asokolsky/AnalogNavigationKeyPad/doc/kit.jpg

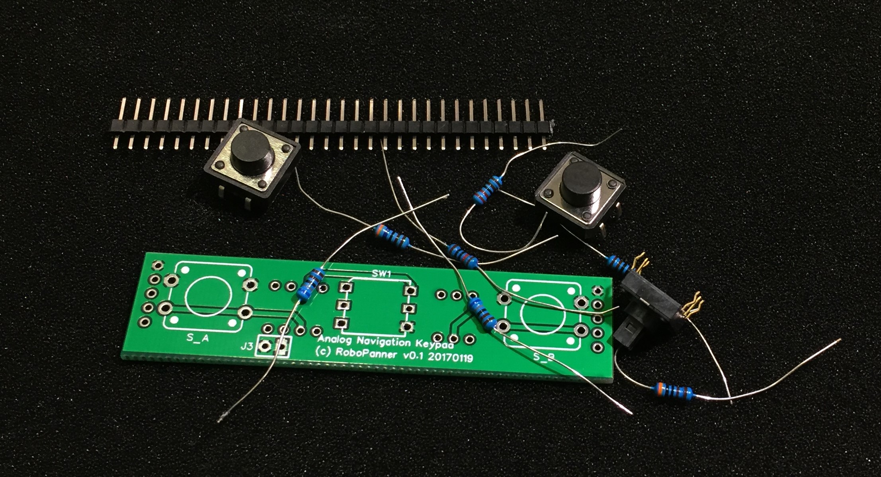
doc/kit.jpg
