asokolsky/AnalogNavigationKeyPad/doc/board.bot.jpg

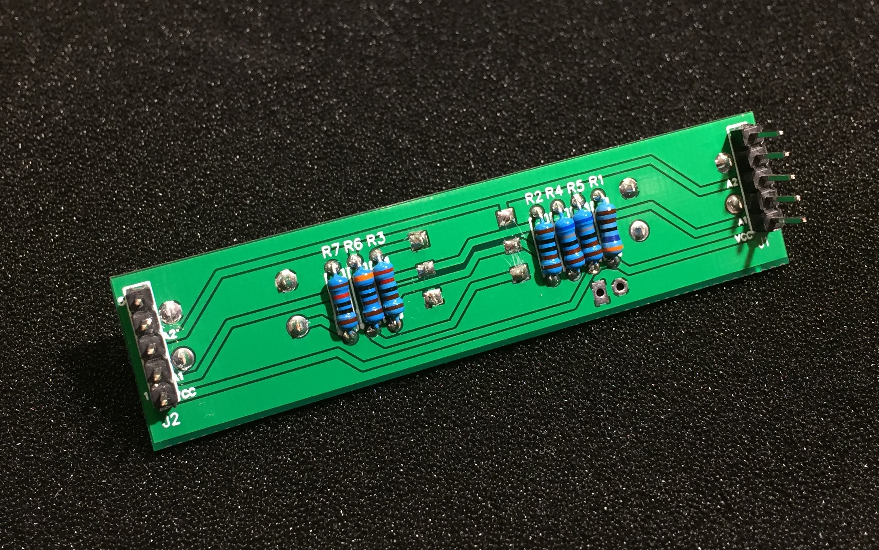
doc/board.bot.jpg
