asokolsky/AnalogNavigationKeyPad/log.md

1/24/2017
GITHUB repository started 

1/19/2017
Schematics and PCB ready.
