asokolsky/AnalogNavigationKeyPad/doc/board.top.jpg

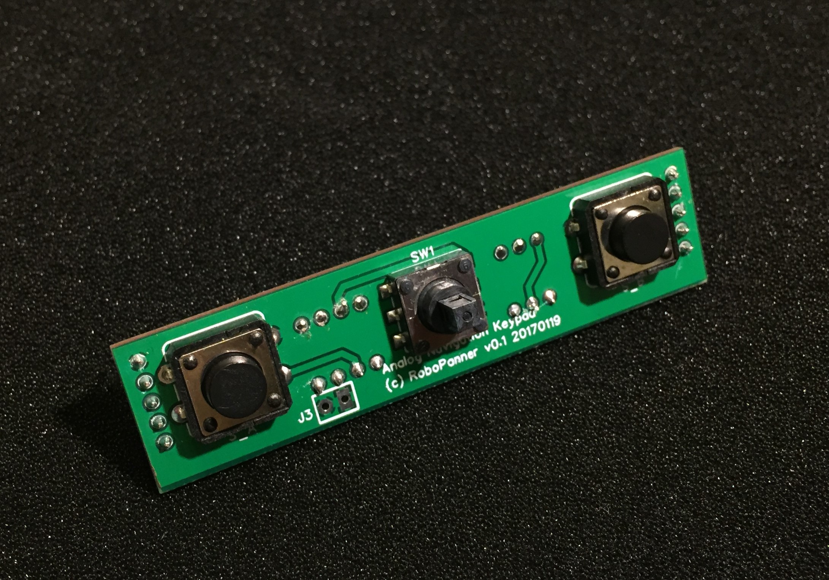
doc/board.top.jpg
