asokolsky/AnalogNavigationKeyPad/doc/PCB.0.1.bot.png

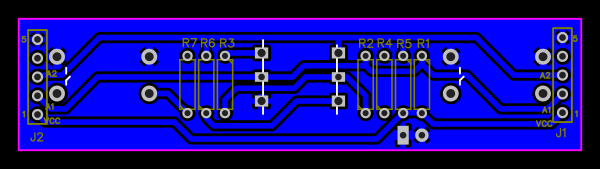
doc/PCB.0.1.bot.png
