asokolsky/AnalogNavigationKeyPad/doc/PCB.0.1.top.png

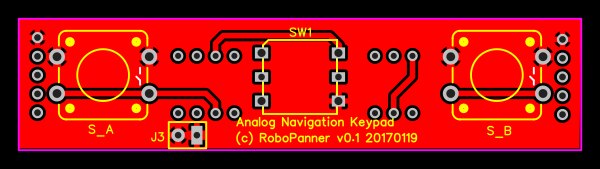
doc/PCB.0.1.top.png
