asokolsky/AnalogNavigationKeyPad/doc/PCB.0.2.bot.png

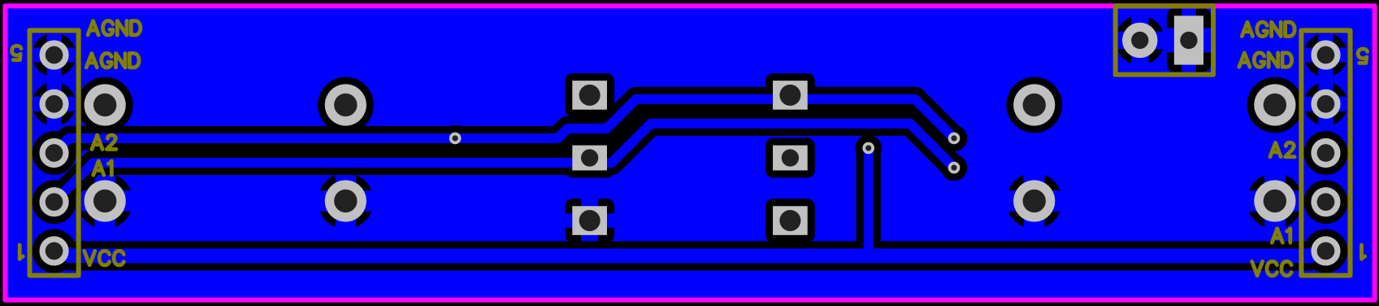
doc/PCB.0.2.bot.png
