asokolsky/AnalogNavigationKeyPad/doc/PCB.0.2.top.png

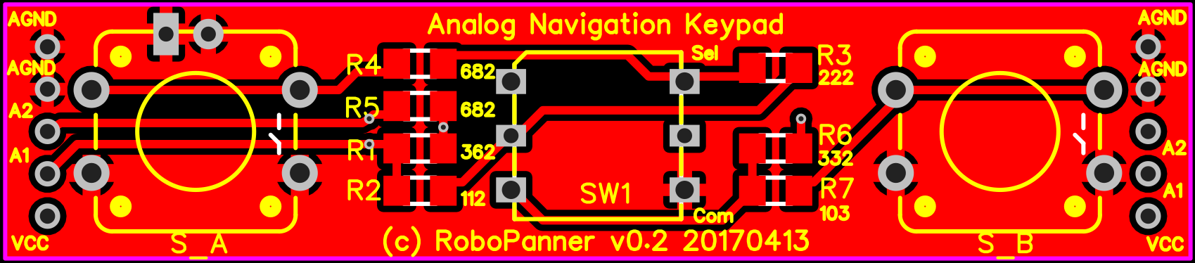
doc/PCB.0.2.top.png
