asokolsky/AnalogNavigationKeyPad/doc/PCB.0.3.bot.png

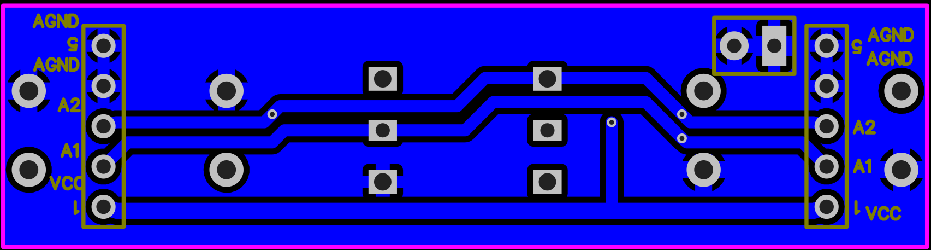
doc/PCB.0.3.bot.png
