asokolsky/AnalogNavigationKeyPad/doc/PCB.0.3.top.png

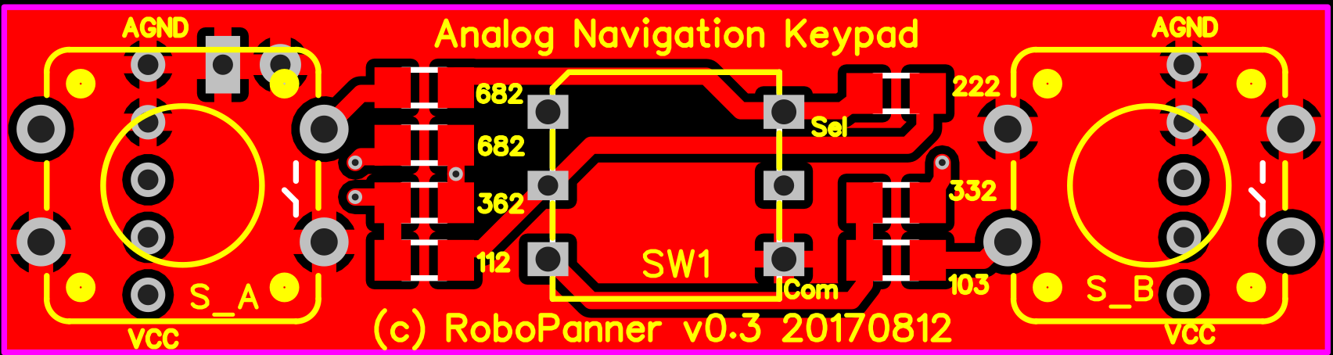
doc/PCB.0.3.top.png
