asokolsky/AnalogNavigationKeyPad/doc/PCB.0.4.bot.png

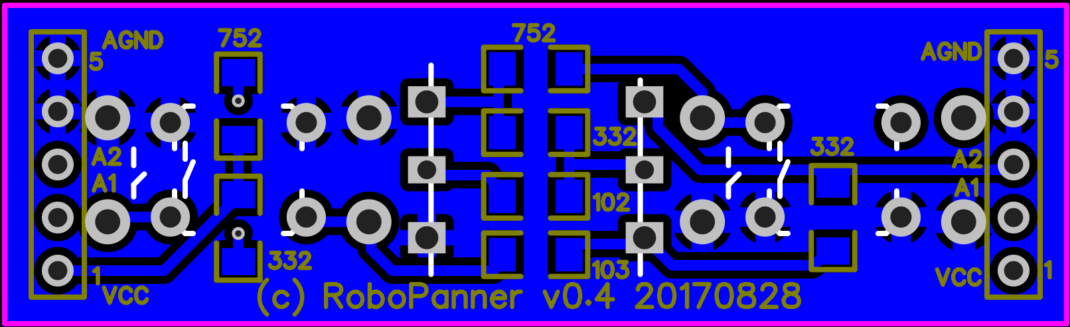
doc/PCB.0.4.bot.png
