asokolsky/AnalogNavigationKeyPad/doc/PCB.0.4.top.png

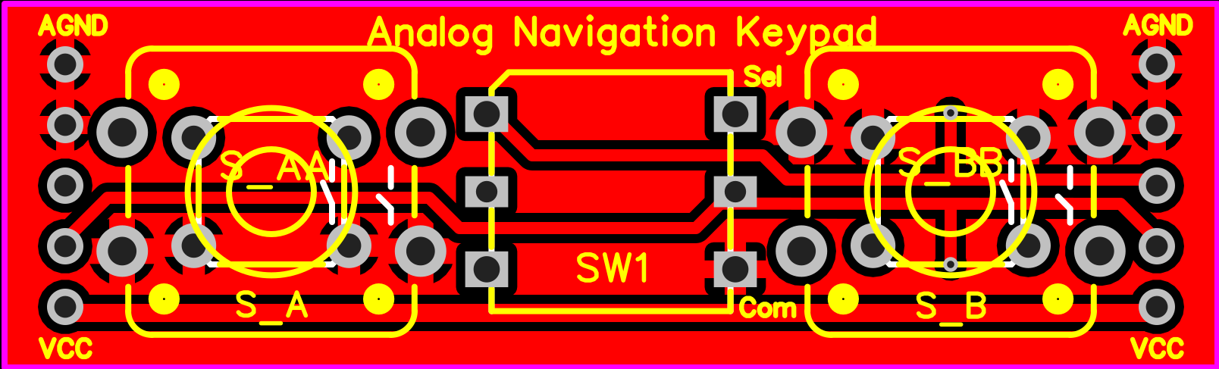
doc/PCB.0.4.top.png
