asokolsky/AnalogNavigationKeyPad/doc/Schematic.0.1.png

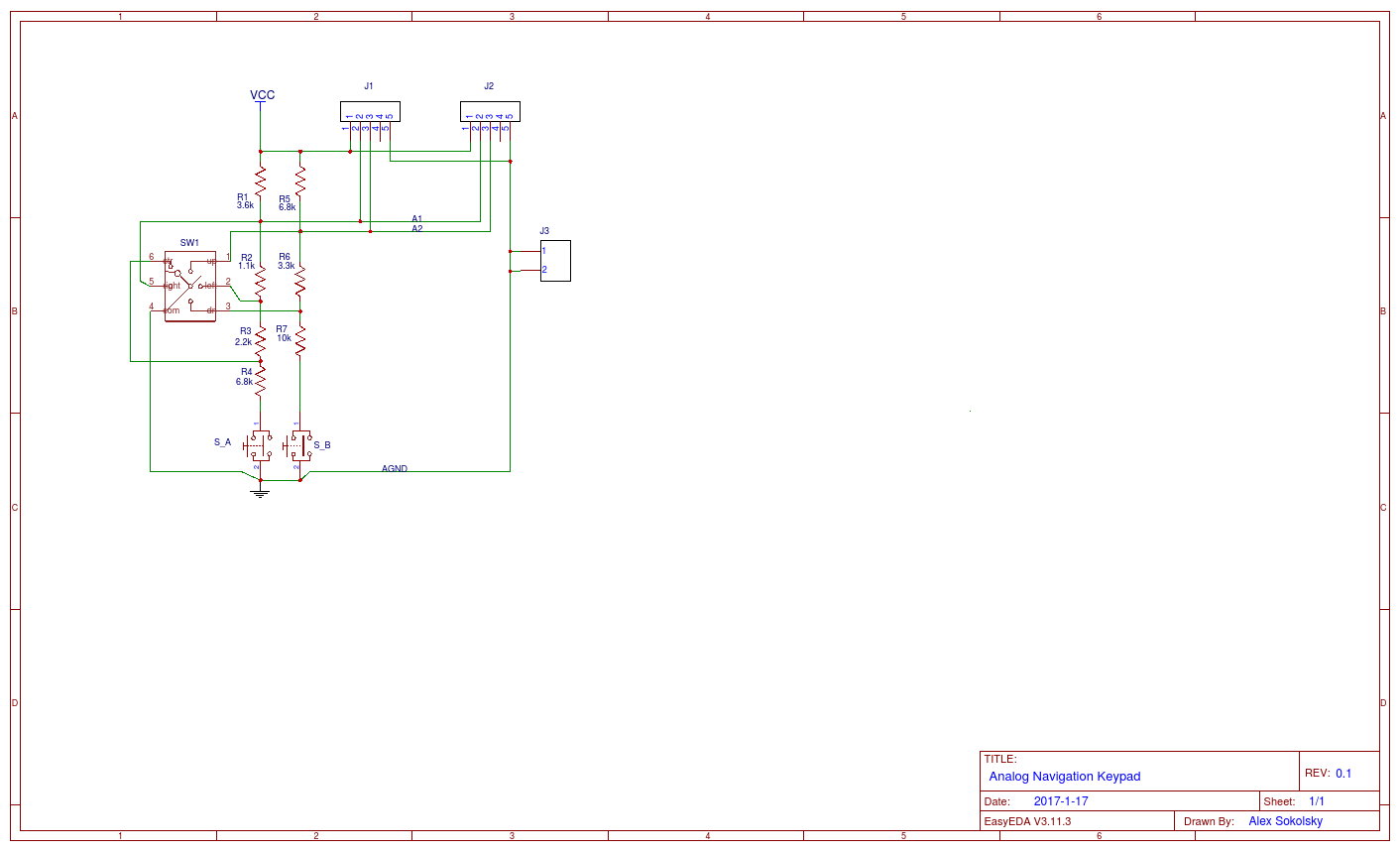
doc/Schematic.0.1.png
