asokolsky/AnalogNavigationKeyPad/doc/Keypad-divider-values.xlsx

Sheet: 7-values
 |  | R, ohm | Reading, Desired | R rounded, ohm | Reading, Actual
Right | R1 | 2200 | 0 | 2.2K | 0
Up | R2 | 365.8314351 | 146 | 360 | 152
Down | R3 | 511.7641933 | 292 | 510 | 295
Left | R4 | 766.7729723 | 438 | 750 | 446
Center | R5 | 1275.631399 | 584 | 1.3K | 606
SoftA | R6 | 2542.585034 | 730 | 2.4K | 727
SoftB | R7 | 7559.036588 | 876 | 7.5K | 873
 | Total: | 15221.62162
 |  | R, ohm | Reading, Desired | R rounded, ohm | Reading, Actual
Right | R1 | 2200 | 0 | 2.2K | 0
Left | R2 | 365.8314351 | 146 | 360 | 152
Center | R3 | 511.7641933 | 292 | 510 | 295
SoftA | R4 | 766.7729723 | 438 | 750 | 446
 | Total: | 3844.368601

Sheet: 4-values
 |  | R, ohm | Reading, Desired | R rounded, ohm | Reading, Actual | Reading | Boundaries
Right | R1 | 3300 | 0 | 3K3 | 0 | 0
Left | R2 | 1100 | 256 | 1K1 | ? |  | 128
Center | R3 | 2200 | 512 | 2K2 | ? | 256
SoftA | R4 | 6600 | 768 | 6K8 | ? |  | 384
 | Total: | 13200 |  |  |  | 512
 |  |  |  |  |  |  | 640
 |  |  |  |  |  | 768
 |  |  |  |  |  |  | 896
 |  |  |  |  |  | 1024
 | Resistance to Values Calculator
 |  | R, ohm | Reading
 | R1 | 3300 | 0
 | R2 | 1100 | 256
 | R3 | 2200 | 512
 | R4 | 6600 | 768
 | Total: | 13200
 | R1 | 3300 | 0
 | R2 | 1000 | 238.1395349
 | R3 | 3300 | 579.3684211
 | R4 | 7500 | 800.2119205
 | Total: | 15100

Sheet: 3-values
 |  | R, ohm | Reading, Desired | R rounded, ohm | Reading, Actual | Reading | Boundaries
Up | R1 | 6800 | 0 | 6K8 | 0 | 0
Down | R2 | 3380.116959 | 340 | 3K3 | ? |  | 170.6666667
Center | R3 | 10239.82439 | 683 | 10K | ? | 341.3333333
 | Total: | 20419.94135 |  |  |  |  | 512
 |  |  |  |  |  | 682.6666667
 |  |  |  |  |  |  | 853.3333333
 |  |  |  |  |  | 1024
 | Resistance to Values Calculator
 |  | R, ohm | Reading
 | R1 | 6800 | 0
 | R2 | 3300 | 334.5742574
 | R3 | 10000 | 677.5721393
 | Total: | 20100
 |  | R, ohm | Reading
 | R1 | 7500 | 0
 | R2 | 3300 | 312.8888889
 | R3 | 10000 | 654.7692308
 | Total: | 20800

Sheet: 2-values
 |  | R, ohm | Reading, Desired | R rounded, ohm | Reading, Actual | Reading | Boundaries
Left | R1 | 6800 | 0 | 6K8 | 0 | 0
Right | R2 | 6800 | 512 | 6K8 | ? |  | 256
 |  |  |  |  | ? | 512
 | Total: | 13600 |  |  |  |  | 768
 |  |  |  |  |  | 1024
