asokolsky/AnalogNavigationKeyPad/(commit log)

2017-01-25 PCB and schematic added
2017-01-25 1st debugged release
    Simultaneous button press works!
2017-08-17 PCB 0.4 added
2017-08-29 Divider calculator added
    [Keypad-divider-values.xlsx]
2017-08-29 More versions of PCB added
2017-09-02 Maple Mini Support and more
    STM32 MCU supported
    Now onKeyAutoRepeat is called only after onLongKeyDown
2023-04-30 Python sample
